whosawhatsis/RepRap-Wallace/base_end_2off.scad

include <wallace.scad>;

!base_end();
