whosawhatsis/RepRap-Wallace/idler_pulleys.scad

include <wallace.scad>;

!for(x = [1, -1]) for(y = [1, -1]) translate([x * (pulley_size / 2 + 3), y * (pulley_size / 2 + 3), 0]) idler_pulley(true);
