whosawhatsis/RepRap-Wallace/leadscrew_couplers.scad

include <wallace.scad>;

!for(side = [-1,1]) translate([0, side * motor_screw_spacing / 2, 0]) leadscrew_coupler();
