whosawhatsis/RepRap-Wallace/x_carriage.scad

include <wallace.scad>;

!x_carriage();
