whosawhatsis/RepRap-Wallace/x_end_left.scad

include <wallace.scad>;

!x_end(0);
