whosawhatsis/RepRap-Wallace/x_end_right.scad

include <wallace.scad>;

!x_end(2);
