whosawhatsis/RepRap-Wallace/y_idler.scad

include <wallace.scad>;

!y_idler();
