whosawhatsis/RepRap-Wallace/(list of files, cad)

Other CAD files:
idler_pulleys_single_bearing.scad
y_bearing_retainers.scad
z_top_clamps.scad
