whosawhatsis/RepRap-Wallace/(commit log)

2011-12-22 Add preliminary rendering of Y axis belt routing.
    [printrbot variant.scad]
2011-12-26 Modify leadscrew nut channel in X ends to make assembly a bit easier.
    [printrbot variant.scad]
2011-12-26 Add shallow nut traps to X end clamping/pulley mounting screws for easier assembly.
    [printrbot variant.scad]
2011-12-26 Shrink feet to reduce elevation and (hopefully) reduce vibration.
    Previously, the threaded rods deflected and acted as springs which
    could increase vibration. Base pieces should now be nominally elevated
    1mm and, with expected deflection of threaded rods, should not be
    elevated at all. Feet now only prevent the machine from tipping, with
    deflection of the rods used to pre-tension them.
    [printrbot variant.scad]
2011-12-27 Switch X motor to the other side to better balance the weight of the axis.
    This deals with an occasional issue of the idler end lagging behind
    when moving down because it is too light. I am attempting to fix this
    by balancing it against the weight of the extruder motor, which is on
    the left side of the X carriage.
    [printrbot variant.scad]
2012-01-03 Add z_top_clamp part
    This allows a threaded rod to be mounted across the top of the Z rods.
    This stabilizes the Z axis in the X direction, and can also be used as
    a handle, making it much easier to transport the machine. The clamp has
    a gusset joint for added strength, and a new parameter has been added
    to control the size of the gusset.
    [printrbot variant.scad]
2012-01-03 new part was displayed in the wrong orientation in the previous commit.
    [printrbot variant.scad]
2012-01-03 and one more minor error
    [printrbot variant.scad]
2012-02-03 New name!
    [wallace.scad]
2012-02-05 Manual pull from domonoky
    Using copy/paste, because I couldn't figure out how to do it the right
    way, sorry! Still a git newb.
    [wallace.scad]
2012-02-05 format normalization
    [wallace.scad]
2012-02-05 Use m3_size * 2 for m3 screw head size
    also, an apothem is measured from the center to the face, so "apothem
    radius" is redundant
    [wallace.scad]
2012-02-05 Missed a couple
    [wallace.scad]
2012-02-06 Update recommended settings in comments
    This addresses some issues that have been reported by people building
    the M8/LM8UU/NEMA17 version.
    [wallace.scad]
2012-02-06 Missed the setscrew nut in the leadscrew coupler
    [extruder.scad, wallace.scad]
2012-02-06 don't look, not ready
    [extruder.scad]
2012-02-06 Add individual files for exporting
    [base_end_2off.scad, bed_mounts.scad, feet.scad, idler_pulleys.scad, idler_pulleys_single_bearing.scad, leadscrew_couplers.scad, wallace.scad, x_carriage.scad]
2012-02-10 Add plates file
    (for M6/LM6UU/NEMA14 version only)
    [plates.scad, pulley with collar.scad]
